schlimme-gegend/nibbleTronic/hardware/nibbletronic_KICAD.kicad_pcb

## KiCad design hardware/nibbletronic_KICAD.kicad_pcb (2017-02-23)

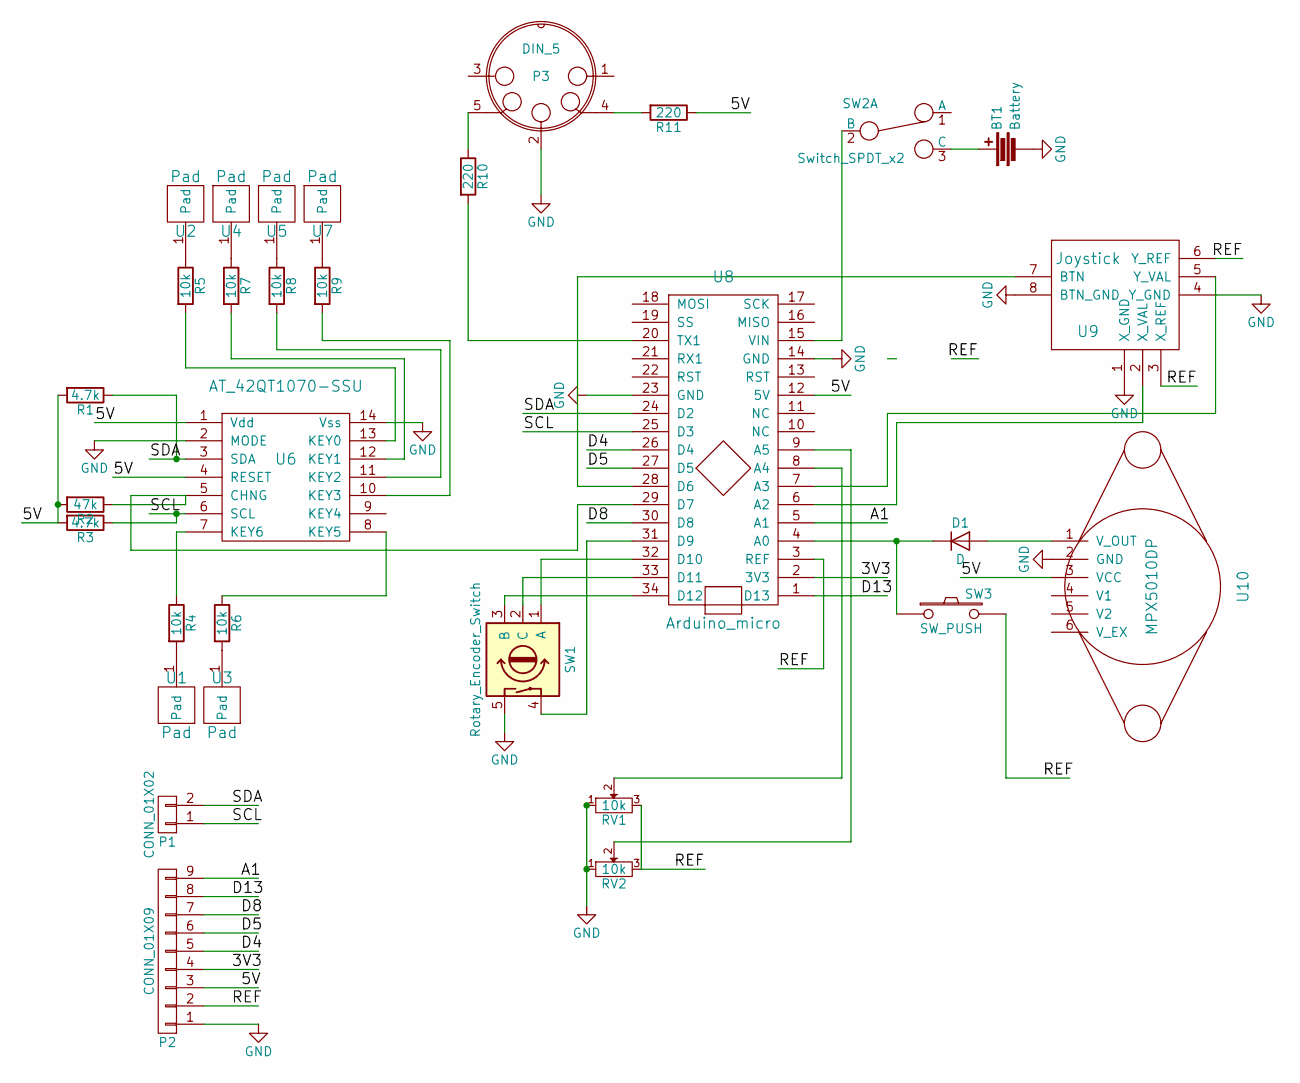
[picture p1: schematic nibbletronic_KICAD.sch]

Parts:
BT1: Battery; 9V_BATTERY_CLIP
D1: D; D_0805
P1: CONN_01X02; Pin_Header_Straight_2x01_Pitch2.54mm
P2: CONN_01X09; Pin_Header_Straight_1x09_Pitch2.54mm
P3: DIN_5; HIRSCHMANN_MAB_5
R1, R3: 4.7k; R_0805_HandSoldering
R2: 47k; R_0805_HandSoldering
R4, R5, R6, R7, R8, R9: 10k; R_0805_HandSoldering
R10, R11: 220; R_0805_HandSoldering
RV1, RV2: 10k; ALPS_402125
SW1: Rotary_Encoder_Switch; ALPS-STEC12E
SW2: Switch_SPDT_x2; ESP40XX
SW3: SW_PUSH; SW_SPST_PTS645
U1, U2, U3, U4, U5, U7: Pad
U6: AT_42QT1070-SSU; SOIC-14_3.9x8.7mm_Pitch1.27mm
U8: Arduino_micro; ARDU_MICRO_SOCKET
U9: Joystick; ALPS_RKJXP
U10: MPX5010DP

Connections:
/3V3: P2.4, U8.2 (3V3)
/5V: P2.3, R1.2, R2.2, R3.2, R11.1, U6.1 (Vdd), U6.4 (RESET), U8.12 (5V), U10.3 (VCC)
/A1: P2.9, U8.5 (A1)
/D4: P2.5, U8.26 (D4)
/D5: P2.6, U8.27 (D5)
/D8: P2.7, U8.30 (D8)
/D13: P2.8, U8.1 (D13)
/REF: P2.2, RV1.3, RV2.3, SW3.2, U8.3 (REF), U9.3 (X_REF), U9.6 (Y_REF)
/SCL: P1.1, R3.1, U6.6 (SCL), U8.25 (D3)
/SDA: P1.2, R1.1, U6.3 (SDA), U8.24 (D2)
GND: BT1.2, P2.1, P3.2, RV1.1, RV2.1, SW1.5, U6.2 (MODE), U6.14 (Vss), U8.14 (GND), U8.23 (GND), U9.1 (X_GND), U9.4 (Y_GND), U9.8 (BTN_GND), U10.2 (GND)
unnamed: BT1.1, SW2.3 (C)
unnamed: D1.1 (K), SW3.1, U8.4 (A0)
unnamed: D1.2 (A), U10.1 (V_OUT)
unnamed: P3.4, R11.2
unnamed: P3.5, R10.1
unnamed: R2.1, U6.5 (CHNG), U8.29 (D7)
unnamed: R4.1, U6.7 (KEY6)
unnamed: R4.2, U1.1
unnamed: R5.1, U2.1
unnamed: R5.2, U6.13 (KEY0)
unnamed: R6.1, U6.8 (KEY5)
unnamed: R6.2, U3.1
unnamed: R7.1, U4.1
unnamed: R7.2, U6.12 (KEY1)
unnamed: R8.1, U5.1
unnamed: R8.2, U6.11 (KEY2)
unnamed: R9.1, U7.1
unnamed: R9.2, U6.10 (KEY3)
unnamed: R10.2, U8.20 (TX1)
unnamed: RV1.2, U8.8 (A4)
unnamed: RV2.2, U8.9 (A5)
unnamed: SW1.1 (A), U8.32 (D10)
unnamed: SW1.2 (C), U8.33 (D11)
unnamed: SW1.3 (B), U8.34 (D12)
unnamed: SW1.4, U8.31 (D9)
unnamed: SW2.2 (B), U8.15 (VIN)
unnamed: U8.6 (A2), U9.2 (X_VAL)
unnamed: U8.7 (A3), U9.5 (Y_VAL)
unnamed: U8.28 (D6), U9.7 (BTN)

Board: 2 copper layers, 31 parts (0 on the bottom side), 40 nets, no tracks yet.
