schlimme-gegend/nibbleTronic/(threads)

Thread 6 (2017-02-08):

Analyse: Touchsensoren

Witzman, 2017-02-08:
Touchsensoren sind sinnvoll, auch wenn ich die Microschalter und ihre Haptik mag. Der Oktavslider sollte auf jeden Fall ersetzt werden.
Welches Bauteil?

Witzman, 2017-02-11:
Bei Reichelt gibts nen AT 42QT1010-TSHR.
Ist ein Touch sensor.
Laut Datenblatt im Fastmode 1,2ms.

Wenn ich das richtig sehe, benötigt der dann nur noch eine "sense Electrode", die auf GND geht.

Klingt schonmal recht brauchbar.

Witzman, 2017-02-11:
Als Ersatz für die noteswitches scheinen die TTP223 zu funktionieren.
https://youtu.be/VKuQ8yB05bU
Ich bestell mir mal 4.

Witzman, 2017-02-16:
Die TTP223 funktionieren.

Danach können die Verbindungen von D0, 2, 3 ,& 4 zu den Kippschaltern aus dem Boardlayout gelöscht werden.
Verbaut sind folgende Sensoren:
https://d1xahwiwo4b49p.cloudfront.net/10129-large_default/ttp223-capacitive-touch-switch-button-self-lock-module-for-arduino.jpg

D0 macht mir irgendwie Probleme, daher würde ich die auf D2,3,4 und 6 (aktuell noch durch Slider belegt, die Variante funzt aber nicht - siehe Slider issue) legen.
Jeder Sensor benötigt 5v, GND und den Output.
Output an die oben genannten Pins, 5V und GND zu allen 4 Sensoren durchschleifen.
Beispiel unter : https://www.youtube.com/watch?v=MpgKnpAbhGo

schlimme-gegend, 2017-02-16:
Es gibt meines Wissens für Touchsensoren ICs, die mehrere Kanäle zur Verfügung stellen, da forsche ich gerade. Das würde uns erlauben, die ganze Hilfselektronik, die der IC benötigt, nur einmal zu bauen.
D0 ist gleichzeitig Serial RX, das kann in der Tat Probleme machen, da die Pins sowieso neu verteilt werden müssen, kann ich das nächste Mal drauf achten, solchen Doppelbelegungen auszuweichen.

Witzman, 2017-02-16:
Yo, so Teile hatte ich zuerst auch gesehen, erschien mir aber zu kompliziert, da ich mich mit i2c nicht auskenne.

Da die ttps total einfach sind und nur einen Ausgang haben, die an den entspr. Pin kommen, konnte ich damit  erst einmal einen schnellen technischen Prototyp bauen und zu testen, ob es mit den schaltzeiten und Toucherkennungen Probleme gibt.

Bei dem Teil von dir hatte ich keinen Plan, wie man da die Elektrode baut.

schlimme-gegend, 2017-02-16:
Die Elektrode wird einfach ein fettes Pad auf der Platine, alternativ kann ich mir vorstellen, da Heftzwecken einzulöten (Kopf als Knopf), um ein wenig taktiles Feedback zu haben. I2c ist gar nicht so schwierig und ein weiterer Vorteil: Es werden Pins frei :)

Thread 8 (2017-02-08):

Integration Drehencoder + weiterer Microbutton

Witzman, 2017-02-08:
Integration eines Endlos Drehencoders und einen weiteren Button auf die Platine.

Witzman, 2017-02-09:
Für Rotary Encoder ist ein Interrupt notwendig, wenn ich das richtig sehe, geht das nur an Pin 0, 1, 2, 3, 7 beim micro.
Ich würde daher die Note Switches von den Pins 2,3&4 auf 10,11&12 legen.

Witzman, 2017-02-10:
Rotary encoder ist prototypisch umgesetztund funktional.
Encoder hängt an Pin 11 & 12 (und 5v + gnd)
Switch des encoders auf pin 10 - aktuell noch keine Funktion im Code.

Ausgabe erfolgt über sendcc im main loop.

Der verwendete Encoder ist kein reiner Encoder, sondern mit kleiner Platine dran.
Sieht so aus:
http://www.nikolaus-lueneburg.de/wp-content/uploads/2016/12/Rotary-Encoder-Keyes-KY-040.jpg

Thread 9 (2017-02-08):

Midi learn

Witzman, 2017-02-08:
Integration eines Midi learn modus.
Steuerbar über Button und drehencoder.

Ggf für visuelles feedback der cc nummer 5 binär kodierte LEDs oder 7 Segment anzeige.
Speicherung der Werte in EEPROM
https://www.arduino.cc/en/Reference/EEPROM

Thread 12 (2017-02-11):

Fader R und L funktionieren nicht.

Witzman, 2017-02-11:

Witzman, 2017-02-11:
Scheinbar liegt hier noch ein Bug im Platinenlayout vor. Habe folgenden Workarround duchgeführt.

- Überbrückung der REF (5V) Pins
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

- Kabel an die Fader angelötet (wenn man auf die Unterseite der Platine schaut, und der midi Port nach vorn zeigt, den jeweils rechten
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

Die Kabel an die freien Ports A4 und A5 gelötet.

Müsste im Platinenlayout hinzugefügt werden.
Dann können die bisherigen Verbindungen zu dem Ports auch entfernt werden. Nur Masse und 5V müssen auf den Fadern bleiben.

Thread 14 (2017-02-14):

Oktavslider durch Touchlösung ersetzen

Witzman, 2017-02-14:
Wie wäre ein Ribbon Controller an der Stelle?
Sowas in der Art...
http://www.exp-tech.de/linear-softpot-ribbon-sensor-100mm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

schlimme-gegend, 2017-02-16:
Fänd ich ziemlich gut, so eine Lösung, und habe ich auch schon drauf herum geguckt, aber 10cm (14 mit Anschluss) sind ein bisschen viel für den Platz. Der kleinere Sensor bei exp-tech (http://www.exp-tech.de/force-sensing-linear-potentiometer-3-6cm-x-1cm-strip) wäre ideal, wenn er nicht so komplex (der liefert Position und Druck) und teuer wäre.
