schlimme-gegend/nibbleTronic/(commit log)

2014-09-16 removed waiting timer from transmitting pressure changes.
2014-09-18 fixed midi bullshit: loade old firmware that talked expected a button on pin 1 wher now the MIDI interface is.
    [MIDIFlute.ino]
2014-10-02 Switched to 4 bit notes plus 2 octavebits.
2016-01-01 Reoragnized folders, added schematics
    [nibbletronic_KICAD.kicad_pcb, nibbletronic_KICAD.sch]
2016-01-02 added .gitignore with definitions to filter .bak and .bck files created byKiCAD
2016-07-11 Added components, created PCB
    [BOM.ods]
2016-07-11 Added footprint library
2016-10-09 Changed footprints for slider, joystick and mode selector switch, added diode and power switch
    [BOM.ods, nibbletronic_KICAD.kicad_pcb, nibbletronic_KICAD.sch]
2016-10-09 merged local copy with hosted repository
    [nibbletronic_KICAD-B.Cu.gbr, nibbletronic_KICAD-B.Fab.gbr, nibbletronic_KICAD-B.Mask.gbr, nibbletronic_KICAD-B.SilkS.gbr, nibbletronic_KICAD-F.Cu.gbr, nibbletronic_KICAD-F.Fab.gbr, nibbletronic_KICAD-F.Mask.gbr, nibbletronic_KICAD-F.SilkS.gbr]
2016-10-09 Changed PCBlayout, added new footprints, changed spacing, switched to SMD diode, resistors, buttons and switches.
    [nibbletronic_KICAD-B.Cu.gbr, nibbletronic_KICAD-B.Fab.gbr, nibbletronic_KICAD-B.Mask.gbr, nibbletronic_KICAD-B.SilkS.gbr, nibbletronic_KICAD-F.Cu.gbr, nibbletronic_KICAD-F.Fab.gbr, nibbletronic_KICAD-F.Mask.gbr, nibbletronic_KICAD-F.SilkS.gbr]
2016-10-11 Changed switches and button due to parts availability, updated BOM
    [BOM.ods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]
2016-12-01 Beginning overhaul of firmware to work with 1.0alpha hardware.
    [BOM.ods]
2016-12-07 Introducing the pressureControlledMIDI class
2017-01-23 included MIDI.h (https://github.com/FortySevenEffects/arduino_midi_library/), hit a brick wall.
2017-01-25 fixed note interpretation
    [nibbletronic_KICAD.sch]
2017-01-25 Moved pressureControlledMidi.send to update method, added comments.
2017-01-25 Added Joystick Y axis, implemented Witzmans mystery fix
    [MIDIFlute.ino]
2017-01-29 Added Noise rediction for Sliders
    My joystick controller kind of flooded the output with 1 value changes when not moved. So i integrated a noise reduction.
    [MIDIFlute.ino]
2017-01-30 Removed output noise
    - added noise reduction into slider class for joystick
    - lowered octave range Slider (constantly changed beween 73 & 83 in highest octve
    [MIDIFlute.ino]
2017-02-19 Beginning Hardware Revision 2.0
    [nibbletronic_KICAD.sch]
2017-02-20 v 2.0 Schematic
    Added touch sensor and rotenc to schematic, removed buttons and octave
    slider, added break outs for unused pins and i2c
    [nibbletronic_KICAD.kicad_pcb]
2017-02-23 Hardware 2.0: Touch Buttons and a RotEnc
    - Microswitches are replaced by touch sensors with a dedicated IC
    - Octave slider has been replaced by two touch sensors
    - Added a Rotenc at pins D10-12 and D9 for the Button.
    - I2C and all remaining pins (A1, D4, D5, D8, D13), as well as GND, Ref,
    3.3/5V have been broken out for easier access
    [nibbletronic_KICAD.kicad_pcb, nibbletronic_KICAD.sch]
